TIS2024-FMFI/telescope-safety/(threads)

Thread 4 (2024-10-07):

Research of available technologies

Mi-Zel, 2024-10-07:
Find usable technologies for implementation.

pavelpetrovic, 2024-10-07:
túto knižnicu sme testovali:
  https://github.com/ElectronicCats/mpu6050

Mi-Zel, 2024-10-07:
https://rpishop.cz/orientace-v-prostoru/2100-waveshare-10-dof-imu-sensor-d-gyroskop-akcelerometr-kompasmagnetometr.html

https://rpishop.cz/senzory/1404-waveshare-10-dof-imu-sensor-c-gyroskop-akcelerometr-kompasmagnetometr.html

Myšlienka na preskúmanie: Nešlo by pomocou kompasu kompenzovať odchylky v meraní akcelerometra? Pripadne ich vyhodnocovať a v správnom čase hodnoty resetovať?

Mi-Zel, 2024-10-07:
Senzory sú závislé na teplote okolia.
Konkrétny príklad jedného senzora je:
Operatívny od -40 do 85 °C
Plná presnosť od 0 do 65 °C

Nakoľko sa nachádzame v otvorenom priestore, potenciálne tu môžu byť vysoké výkyvy teplôt (hlavne negatívne), ktoré by mohli ovplyvniť meranie.

Pri výbere technológií treba pamätať j na fakt, že sa nachádzame v otvorenom priestore, pripadne vyriešiť ohrev komponentov. Na teploty >0. Je možné,  že systém sa bude ohrievať sám spotrebou elektriky. Treba však na túto potenciálnu hrozbu pamätať.

pavelpetrovic, 2024-10-08:
ano, väčšina senzorov má zabudovaný aj teplomer, ak to bude v uzavretej krabičke, tak už aj to pomôže, lebo si to bude trochu kúriť, ale pridať tam ešte nejaký rezistor, napr. https://techfun.sk/produkt/rezistor-vykonovy-rozne-typy/ povedzme pripojený cez nejaký spínací tranzistor na jednom PWM pine by mohlo príliš nízku teplotu upraviť.

Mi-Zel, 2024-10-14:
Cele by sa to dalo nasetupovat pomocov RPi (alebo inych obdobnych zariadeni).
RPi5 (alebo nizsia rada) by bolo pripojene k Ethernetu a malo tak pripojenie na siet. Zaroven by si vytvaralo vlastnu bezdrotovu siet, do ktorej by sa pripojil modul, ktory by bol na dalekohlade (RPi Pico W alebo RPi Zero W). Komunikacia by sice bezala na rovnakej frekvencii ako wifi (2.4), ale tato frekvencia stale spada pod radiove vlny, ako je v poziadavkach a ma implementovanu spolahlivu komunikaciu s Collision Avoidance. RPi5 by nasledne sluzilo ako jednoduchy webserver pre zobrazenie informacii a konfiguraciu systemu.

Dalsie mozne riesenie komunikacie je pouzit radio modul [NRF24L01](https://techfun.sk/produkt/nrf24l01-2-4ghz-modul-pre-prenos-udajov/), ktory podporuje full-duplex komunikaciu. Tento modul by sa dal v pripade nedostatocneho vykonu vymenit za vykonnejsi modul, ktory obsahuje zosilovac signalu [NRF24L01 PA/LNA](https://techfun.sk/produkt/nrf24l01-palna-2-4ghz-modul-s-antenou/).
Oba pouzivaju identicku kniznucu a identicky medzikus ([adapter](https://techfun.sk/produkt/adapter-pre-bezdrotovy-modul-nrf24l01/)) pre odladenie napati. Modul ma istu formu ACK. Podla nej si vieme znovu posielanie packetov konfigurovat sami, alebo pouzit moduly z kniznice (modul by sa mal pokusit opakovane zasalt packet 15x). Modul je mozne nastavit na 125 roznych kanalov a v kazdom kanale otvorit pipes na komunikaciu s vlastnymi adresami. Kazdy modul vie mat otvorenych 6 pipe (1 na ACK, takze 5 uzivatelskych). Takto moze byt jedna nastavena na odosielanie a druha na prijimanie dat pre full-duplex komunikaciu.

pavelpetrovic, 2024-10-15:
Tie moduly, čo píšete, myslím komunikujú na 2.4 GHz, a preto by sa pravdepodobne rušili s Wifi. Dr. Žigo hovoril o frekvencii 868 MHz. Na tom fungujú tie moduly typu LoRa, dal som aj linku na také, čo aj budeme čoskoro mať na otestovanie do katalógu požiadaviek. Zatiaľ verím, že by mali fungovať tak, že naraz môže komunikovať aj viac ako dve zariadenia, takže by sa jednoducho dala dupliklovať riadiaca jednotka, aby mohla byť aj v miestnosti, kde je teleskop - lebo tam podľa mňa treba niečo mať, nikto nebude loziť hore na teleskop, aby to konfiguroval a určite ale chcú mať aj niečo tam, kde je výskumník, takže mi to vychádza, že treba mať dve - ak budú na tej istej "rádiovej sieti", tak môžu byť jednoducho duplikované a navzájom si mirrorovať informácie, ak používateľ nejaké zadá priamo cez jednu z nich. Informácie, ktoré by vysielala inerciálna jednotka by mali zachytiť obe.
Celkovo hardvér, ktorý je aktuálne vylistovaný v odkazoch, budete mať veľmi čoskoro dostupný na testovanie. K riadiacej jednotke - aby sme zbytočne nepremršťovali cenu by sme asi mohli použiť Raspberry Pi Pico, ktoré komunikuje aj po ethernete - alebo ak by to nebolo dostatočne dobré, tak potom asi Raspberry 4, ale myslím, že bohate bude stačiť 2GB pamäte, lebo pamäť ich dosť premršťuje. To relé by asi malo byť vyvedené ešte von do nejakej inej škatulky, kde bude aj (prerušiteľná) zásuvka na 230V, aby do škatulky s riadiacou jednotkou nešlo priamo 230V.

Mi-Zel, 2024-10-15:
Rozprávali sme sa s nimi o 2 prijímacích zariadeniach, na čo nám bolo povedané,  že chcú iba jedno v riadiacej miestnosti,  do ktorej budú zaradené 2 drôty z riadenia pohybu na potrebné odpojenie (chcú od nas, len aby na tej jednotke bolo relé)
Majú to teda byť čisto 2 zariadenia: jedno s gyroskopom a druhe s displayom, relé spínačom, ktoré bude navyše zabezpečovať komunikáciu s užívateľskými zariadeniami.

pavelpetrovic, 2024-10-15:
Ja viem, ved som tam bol, ale myslim si, ze to nemusi byt finalna predstava, diskutovalo sa aj o tejto moznosti pocas diskusie a mne sa zda, ze tie dovody, ktore som napisal, skor hovoria za to riesenie s dvoma. Je to ale vyspecifikovane tak, ze to skoro vobec neovplyvnuje, ci budu dve alebo jedna, len treba dat pozor, aby sa to navzajom nebilo a este aby sa odzrkadlilo na druhu jednotku co pouzivatel vyberie, to nie je tak narocne. Ale tak ako to je vyspecifikovane by to vyhovovalo aj rezimu prace iba s jednou jednotkou a taketo riesenie je elegantne v tom, ze umozni aj dve, ak sa to niekedy bude zdat uzitocne a zaroven umozni prevadzku aj s jednym.

pavelpetrovic, 2024-11-04:
Zo stretnutia:

- prosim poriadnejsie zapisnice - treba uz pracovat aj na testovacich scenaroch
- neviem, ci som Vam uz ukazoval, ze mame aj alarm sirenu - ktora blika aj sialene vresti, je na 12V, ale mame k nej prevodnik z 5 na 12V, este nam chyba ta powerbanka
- navrhnite svoj komunikacny protokol medzi jednotkami a zdokumentujte ho v navrhu
- treba nakreslit navrh pouzivatelskeho rozhrania
- nasli sme softverovu SPI kniznicu https://github.com/red-scorp/SoftSPIB
- treba zistit ako sa daju prepinat piny na RPI PICO pre HW SPI - lebo su tam osadene viacnasobne alternativy, zrejme nejakym registrom sa to prepina/vybera?
- zatial skusime ist tou cestou, ze vsetky zariadenia budu RPI PICO - bud s ETH modulom pre riadiacu jednotku alebo PICO2 pre inercialnu jednotku, cize k riadiacej by mal byt pripojeny: ETH kabel, radio modem, tlacidla, display s SD kartou, alebo display a SD karta, k inercialnej jednotke iba senzor a radio.  ak s tym budu problemy, tak sa prepneme na ten RPI ZERO s externym modulom pre ETH.
- ten dalsi senzor, co je na ceste je tento https://www.aliexpress.com/item/1005005494956365.html (pridal som ho do zoznamu v KP)
- ja vyskusam modem a displej, Vy vyskusajte web server
- ak chcete stvrtok poobede sa da prist testovat senzory...

Closed 2024-12-16.

Thread 10 (2024-10-14):

Plán implementácie

Mi-Zel, 2024-10-14:
v akom poradí sa budú implementovať, testovať a navzájom spájať jednotlivé komponenty

JanRZ003, 2024-12-08:
Modul s inerciálnou jednotkou
program v jazyku C vytvorený vo vývojovom prostredí Arduino IDE na Teensy doske pre získanie údajov z inerciálnej jednotky 10 DOF IMU Sensor,ICM20948 vo forme Eulerových uhlov, výpočet kvaterniónov
program na Teensy doske pre vysielač Arduino Lora v jazyku C vytvorený vo vývojovom prostredí Arduino IDE na rádiové zasielanie údajov získaných vo vyššie opísanom programe Ján Radovan Zubo 🐤

Riadiaca jednotka
program v jazyku C vytvorený vo vývojom prostredí virtual studio code pre spracovanie údajov prijatých u prijímača arduino lora
program v jazyku C na vyhodnotenie nebezpečenstva podľa získaných a konfiguračných údajov, spúšťanie alarmu, vypnutie systému Ján Radovan Zubo 🐤

program v jazyku C pre príjem HTTP requestov a distribúciu statických súborov
program v jazyku C pre príjem HTTP POST requestov na konfiguráciu systému
program v jazyku C pre príjem HTTP POST requestov na zipovanie a stiahnutie logovych dat
program v jazyku C pre upgrade HTTP na WebSocket a naslednu distribuciu aktuálnych dát z inerciálnej jednotky Mikuláš Zelenák 🦊

program pre logovanie dát, posielanie na webový server
program na vypísanie dát na displej Ivana Zeleňaková 🐹

program v html, css a javascript jazyku pre stránky používateľského rozhrania(konfiguračná stránka, informačná stránka) Mariia Lementa 🦝

pavelpetrovic, 2024-12-09:
ak by ste nemali nic proti, tak by som hlasoval skor za RPI PICO ako Teensy, predsa len je to 7 Eur vs. 44 Eur. Aj keby ste nutne chceli mat SD-kartu pri gyroskope, tak modul pre SD kartu je 1.20...  Myslim si, ze z hladiska programovania ani nepocitite rozdiel.

Pri testovani som pouzil teensy, lebo ten som mal v prostredi Arduino uz rozbehany a bol po ruke, ale inak by to malo byt jedno.

Tiez by bolo super, ak by sme vedeli otestovat aspon dva rozne senzory v realnych podmienkach (snad najskor na tom modele, co ste zostrojili), aby sme ich vedeli porovnat.

Potom tiez netreba riesit nejaky HTTP alebo nebodaj Websocket az na inercialnej jednotke, lebo budu prepojene s riadiacou tym radiovym modemom, takze tam funguje posielanie oboma smermi podla protokolu, ako si spravite, nemusite riesit HTTP.

Nezabudnite na to, ze pred implementaciou  je potrebne tieto veci este aj navrhnut a zapisat do navrhu.

Thread 19 (2024-10-24):

HW testing

Mi-Zel, 2024-10-24:
Test all the sensors and other HW

Mi-Zel, 2024-10-24:
https://www.raspberrypi.com/documentation/microcontrollers/c_sdk.html#sdk-setup

Mi-Zel, 2024-11-04:
Sposoby ako zdieľať data medzi jadrami:
https://forums.raspberrypi.com/viewtopic.php?t=340588

pavelpetrovic, 2024-11-25:
prvy test - dve radia komunikuju z arduina ok
https://www.youtube.com/shorts/FG-sJ_2mkPE
pouzil som tuto kniznicu https://github.com/sandeepmistry/arduino-LoRa
zatial jedno je vysielac, druhe primac, neskor este otestujem obojsmerne

pavelpetrovic, 2024-11-27:
len hlasim, ze komunikacia medzi radiami funguje pekne aj obojsmerne
(z kniznice priklad LoRaDuplex.ino)

pavelpetrovic, 2024-11-30:
Displej aj SD-karta, ktora je v nom funguju...
https://www.youtube.com/watch?v=oertZe1MlqU
(subor tam ostal - ako hovorim na videu - iba ked sa zmazanie zakomentovalo, inak bol zmazany)

pavelpetrovic, 2024-11-30:
pokracujem testom senzora SparkFun 9DoF - ICM-20948, v predchadzajucom sa quaterniony pocitali tou softverovou kniznicou, tu sa pocitaju v DMP priamo v hardverovom cipe. Akurat je tym padom kod taky velky, ze to nevojde do 32KB flash obycajneho Arduina, takze som pouzil Teensy 4.1, ale bez problemov to slo. V zdrojakoch kniznice treba odkomentovat, aby sa DMP pouzivalo (je to navrchu zdrojaka prikladu vysvetlene). Pouzita je standardna kniznica od Sparkfun k tomuto senzoru. Ma trochu problem, ze po inicializacii trva chvilu, kym sa ustalia hodnoty, najma roll, potom uz zda sa funguje. Testoval som iba rezim 6DOF, kedze kompas asi nebude pouzitelny. Takze toto tiez kandiduje na pouzitie a bolo by ich dobre porovnat dokladnejsie.
https://www.youtube.com/watch?v=VX2zd2Eqg7Y
knzinica je ICM_20948.h, priklad 7.

pavelpetrovic, 2024-11-30:
skusil som aj ten modry - jeden taky podobny, len trochu iny mate...
tento obsahuje MPU9250 a kompas, ale hoci sa mi zdalo, ze to mozno pouziva aj kompas,
tak to bude myslim iba tych 6DOF (co je dobre).
pouzil som kniznicu fastIMU, https://github.com/LiquidCGS/FastIMU
ktora podporuje cely rad roznych IMU a aj tento...
quaterniony, ak som dobre pochopil sa tiez rataju vnutri v DMP.
pridal som do programu prepocet na YPR - len zobral z ineho programu vyssie, kde ten vypocet bol tiez.
tomuto trva tusim este dlhsie, kym sa na zaciatku najde a potrebuje pomerne dost narocnu kalibraciu - ktora sa ale da preskocit
a pouzit predtym vytvorena.
https://youtube.com/shorts/x0EQ1ctWCxU

pavelpetrovic, 2024-11-30:
Tak aj ten posledný gyro funguje celkom pekne. Dá sa mu nastaviť jeden z viacerých možných módov, tak som vybral taký bez kompasu. Má aj samostatný program na kalibráciu. Použil som knižnicu https://github.com/arduino-libraries/BNO055
ak som dobre pochopil tak od výrobcu.
Tento zdá sa nemá problém s hľadaním hodnoty na začiatku, vyzerá byť trochu závislý od kalibrácie. A keď nepoužíva kompas, tak sa snáď ani nebude automaticky resetovať ako písali na nejakých fórach.
https://youtube.com/shorts/yloB6HkRB1A

pavelpetrovic, 2024-11-30:
podarilo sa Vám rozbehať ten webový server, alebo skúsim aj to?

Mi-Zel, 2024-11-30:
Áno. Webový server je pushnuty funkcny v branch-i na testovanie

pavelpetrovic, 2024-12-09:
doplnam spravne nastavenie pinov pre radia:

const int csPin = 10;          // LoRa radio chip select
const int resetPin = 9;       // LoRa radio reset
const int irqPin = 2;         // change for your board; must be a hardware interrupt pin

pavelpetrovic, 2024-12-13:
dobré správy:

rádio a SD karta z W55RP20-EVB-PICO fungujú súčasne, pričom ostávajú ešte voľné piny:
0,1,9,14,15,26,27,28 - z toho 0,1 je bežná sériová linka, tadiaľ by to mohlo komunikovať s Arduinom, aby
mu posielalo príkazy, čo vykresliť na displeji, prípadne kam používateľ klikol, ak chceme využiť aj dotykový
displej a stále ostáva 6 pinov. dúfam, že keď sú rádio aj SD karta pripojené, tak bude fungovať aj ethernet...
toto by bolo ešte treba vyskúšať. Teraz mám pocit, že bude asi najlepšie dať tam toto arduino nano a nebude
treba odrezávať nožičky pre SD kartu z displeja zvlášť.
prikladám program, ktorý komunikuje cez rádio aj obsluhuje SD-kartu, ktorý mi ide:
[picoeth_sd_and_radio.zip](https://github.com/user-attachments/files/18125726/picoeth_sd_and_radio.zip)

ešte som konečne skúšal aj aký dosah má rádio. nie je to až také valné, ale v tejto budove je veľa železobetónu:
keď bolo rádio v labe, tak som ešte zastihol signál v polovici chodby smerom k oáze so šachovnicou a v tej
prepojovacej chodbe pozdĺž celej H6, ale pri H3 už nie. Takže keď nabudúce niekto pôjde na hvezdáreň,
treba to tam ísť vyskúšať. Ale ešte tam bol aj pin ANA, ktorý je asi iba zle označený pin ANT. ChatGPT poradil
vzorec, ktorým sa dá vypočítať správna dĺžka antény, tak som tam napájkoval 8.6 cm pevný drôt na oba
a rozsah sa zvýšil tak, že sa dá vyjsť von z informatiky a až v tej chodbe na vrátnicu to začne viac blbnúť.
Celkovo ale bude treba kontrolovať prijaté pakety a opakovať, keď sa neprijmú správne, občas to nejaké
písmenko zmení - najmä keď už je to ku koncu vzdialenosti. Asi sa tam ešte softvérovo dá upraviť nejaký
register, aký má gain, ale to až zasa nabudúce. Ale už aj takto je to teda zrejme dosť, takže to ani netreba
ísť skúšať.

pavelpetrovic, 2024-12-16:
prepojil som SD-kartu s dalsim PICO aby sa to dalo rozdelit.
takze tu su dva programy - pre adruino a pre pico2, pricom
pico2 chodi na SD kartu a Arduino na displej.

navzajom komunikuju cez SoftwareSerial - funguje to.
[displej_a_sd.zip](https://github.com/user-attachments/files/18148543/displej_a_sd.zip)

pavelpetrovic, 2024-12-18:
Prekonzultoval som pre istotu s nasim spravcom, co vravi na to riesenie s mDNS.
Vravel, ze je to sice malo vyuzivana, ale ze jeden system na katedre tak funguje a vzdy to zafunguje a ze by s tym nemali byt problemy, takze stahujem moje frflanie na mDNS - urobte ako chcete - ci uz cez ten skript na nejakom servri na fakulte, alebo cez mDNS ako local adresa.

pavelpetrovic, 2025-01-20:
Po troch hodinach zabavy sme nasli sposob, ako urobit webserver na tej veselej doske W55RP20-EVB-PICO.
V tomto projekte to sice este nie je webserver, iba TCP server, ale to uz je snad malina.

pouzili sme default example Wifi-WifiServer a lwIP_w55rp20-WifiClient-W55RP20.

[w55rp20-evb-pico-eth-tcp-server.zip](https://github.com/user-attachments/files/18481206/w55rp20-evb-pico-eth-tcp-server.zip)

Mi-Zel, 2025-02-06:
Pri snahe zapisat schemu som objavil ze sa antena na radii toci. Je pevne v lepidle (nevytahuje sa) ale toci sa v nom.
Obavam sa ze tam nie je najlepsi kontakt a pred instalaciou to bude treba prepajkovat.

pavelpetrovic, 2025-02-08:
zohnal som nejake dve powerbanky, pripravil napajanie a predbezne som vypotil krabicku pre inercialnu jednotku, skusim vytlacit, na prvy raz to takmer isto nesadne, ale treba vyskusat. skusim aj pre riadiacu, to bude vacsia fuska, zislo by sa, keby ste to potom doniesli, napr. v pondelok, aby sme dotiahli kabelovanie...
https://www.tinkercad.com/things/2qtOncCJI9N-inercial-unit

Thread 23 (2024-12-02):

Issue cviciaci

pavelpetrovic, 2024-12-02:

pavelpetrovic, 2024-12-02:
2/12
Mikulas je chory ostatni pritomni
v zapisnici musi byt napisane, kto ma co na starosti do buduceho tyzdna
vysoka priorita je dokladne v time prediskutovat:
1) navrh pouzivatelskeho rozhrania, aby ho niekto mohol nakreslit
2) rozdelenie na moduly a ich rozhrania, tiez niekto zdoumentuje formou UML component diagram
3) plan implementacie - s podrobnymi jednotlivymi ulohami, ktore sa idealne daju nezavisle vykonat (a teda z nich asi budu issues, alebo budu zdruzovane do vacsich issues)
potom spojit vsetko do hotoveho navrhu.

pavelpetrovic, 2024-12-09:
9/12
vsetci pritomni
zapisnica OK
tim vypracoval navrh rozdelenia na casti a komponentny diagram: ok
tim vytvoril plan implementacie: moze byt
tim vytvoril navrh pouzivatelskeho rozhrania - v navrhu prosim timy, aby vypracovali kompletny navrh aj tie casti, ktore su "optional", aby bol urobeny tak, aby sa tie casti potom dali pridat, ked sa pridavat budu
inak celkovo dobra praca.

je potrebne vytvorit implementacne issues a este raz sa v time podrobne porozpravat ako sa budu implementovat jednotlive casti - idealne vytvorit prazdne hlavicky metod a tried pre cely projekt,

potom ich uz mozu jednotlivi vyvojari podoplnat.

Myslim si, ze az tak nie je potrebne teraz robit dalsie testovanie hardveru, kym nemate softver, ten pojde vychodiskovo skompilovat aj na RPI PICO aj na Teensy - oboje ak sa bude programovat z prostredia arduino

mame jednak PICO W a jednak PICO 2 a jednak to PICO s ethernetom (W55RP20-EVB-PICO); beznym rozsirenim pre HW dosky od Arduina idu iba niektore, ale vsetky by mali ist tymto rozsirenim:
https://github.com/earlephilhower/arduino-pico
vyskusal som vsetky tri naprogramovat jednoduchy program a naspat vypisovat cez USB na seriovy port a vsetky tri isli - aj ten napajkovany, co ste mali, aj tie zvysne dva

vyskusam prepojit displej s tym W55RP20 a uvidime, kolko ostane pinov volnych, ci aj I2C este ostane volna a druhe SPI - a tiez, ci to dokaze teensy - toto si beriem na zodpovednost vyskusat.

cize asi netreba, aby ste sem chodili vsetci spolu testovat hw, az ked niekto bude mat nejaky SW komponent, ktory nejaky HW potrebuje, tak sa dohodne individualne a pride otestovat.

zamerajte sa, prosim, na to spolocne premyslenie implementacie az na uroven metod a potom kazdy na naimplementovanie vlastnej casti.

pavelpetrovic, 2025-01-04:
Asi viete, ale pre istotu: potom ak by ste nahodou robili v Arduino IDE vacsi projekt, tak tam moze byt aj viac suborov - tie maju potom priponu .cpp, pripadne .h a iba jeden sa vola .ino, podla neho sa vola aj adresar v ktorom je. Vsetky tieto sa zobrazia potom po otvoreni toho .ino ako jednotlive zalozky v IDE. Takto mozno udrzat jednotlive subory tematicky zamerane a v rozumnej dlzke. Vela zdaru.

pavelpetrovic, 2025-01-20:
pekny clanok o doske s eth:  https://community.element14.com/technologies/internet-of-things/b/blog/posts/review-wiznet-w55rp20-evb-pico

pavelpetrovic, 2025-02-15:
pozrel som si dokument, mam este tieto drobne postrehy:

- predovsetkym potrebujem, aby v dokumente bol komunikacny protokol medzi jednotkami
  (konkretne pakety do posledneho bitu, ktore si vymienaju, aj aspon nejaka veta-dve k tomu)
- popis protokolu medzi W55RP20-EVB-PICO a arduino
- popis websocket protokolu, ake tam chodia pakety
- to API, ktore tam mate vysypane... hmm.
  je to trochu neprehladne. dalo by sa bud pouzit nejaky doxygen a spravit z toho poriadnu api dokumentaciu, ale to asi pre tento projekt netreba,  ale aspon keby tam bol syntax highlighting. myslim, ze ak by to bolo v inom IDE ako arduino, tak copy&paste do wordu by mohol zachovat zvyraznenie syntax highlighting, mozete pripadne vyskusat...
- mozete trochu pozriet aj preklepy, napr:
- V moduli s inerciálnou jednotkou => https://www.eduself.sk/slovensky-jazyk/tvary-slova/modul
- bezdrátovú => po slovensky drôt, nie drát :)
-  azimutu a elevácia => e
- MAC adreru
- Všetku logové súbory
- poligóny => y
- pred "a uložiť ich do Dokumenty/Arduino/libraries" by som pridal
   "bud priamo pomocou Arduino IDE Library managera alebo ich uložiť..."
- hardver, k inercialnej jednotke mozete pridat:
    - zdroj 5V4A (https://chipskey.en.made-in-china.com/product/ATJRiUelIGWN/China-47126-Output-5V-97-Mini-DC-DC-15V-12V-9V-7-4V-to-5V-4A-Step-Down-Buck-Power-Converter-Charging-Volta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)
    - powerbanka (https://www.alza.sk/spello-vreckova-powerbanka-5000-mah-cierna-d12422928.htm)
    - link na radio je: https://techfun.sk/produkt/komunikacny-modul-sx1276-lora-433-868-915-mhz/
- mate tam 2x schemu riadiacej jednotky, inercialna je tu:
   https://github.com/TIS2024-FMFI/telescope-safety/blob/main/docs/schemes/inertial_unit.png

- hardver k riadiacej jednotke:
   link na displej: https://techfun.sk/produkt/tft-display-shield-3-5-pre-arduino-uno-s-sd-kartou
   link na mosfet: https://techfun.sk/produkt/dual-mosfet-pwm-regulator-aod4184a/
   link na rele: https://techfun.sk/produkt/rele-modul-1-kanal-5v/
   link na sirenu: https://techfun.sk/produkt/sirena-12v-ls-103/

- v dokumente by mali byt aj testovacie scenare
- mozete pridat aj link na krabicku pre inercialnu jednotku, prip. aj jej obrazok ako sa zobrazuje na tinkercade
   https://www.tinkercad.com/things/2qtOncCJI9N-inertial-unit

Thread 24 (2024-12-15):

Sensor data gaining

JanRZ003, 2024-12-15:
Implementation issue for module with inercial unit

JanRZ003, 2024-12-15:
-v branchi pre modul s inerciálnou jednotkou som pushol kod na nacitavanie dat(Eulerovych uhlov) do serial monitoru v arduino IDE
-rozbehol som to cez raspberry pi pico 2 so senzorom waveshare 10 DOF IMU sensor (D) ICM_20948
-dalsia aspiracia je transformacia na elevaciu a azimut

JanRZ003, 2025-01-01:
získavanie roll, pitch, yaw pomocou senzoru waveshare 10 DOF IMU sensor (D) funguje a je to už aj sem pushnute do repozitára v dohodnutej forme návrhu implementácie, ešte v rámci tejto issue spravím získavanie týchto údajov pomocou iných senzorov s využitím iných knižníc, ale to až neskôr, nakoľko chcem spraviť progres aj v iných issues

Closed 2025-01-21.

Thread 25 (2024-12-15):

Transmitting data via radio

JanRZ003, 2024-12-15:
Implementation issue where updates on transmitting data(from module with inercial unit to control unit via radio)will be documented through comments

JanRZ003, 2025-01-13:
-pushol som do repozitara do paralelnej branche funkcny kod ktory posiela cez lora modul azimut a elevaciu kazdu pol sekundu ktore sa prave namerali
-skusal som to normalne na raspberry pi pico 2, kedze napajanie a zem(3v3 a gnd) na mikropocitaci vyuziva senzor(inercialna jednotka) tak som radio napajal cez mikropocitac s ethernetom(toto este treba poriesit cez breadboard napriklad)
-azimut a elevaciu som posielal mikropocitacu arduino nano ktory ma stale level shiftery
-aj spätna komunikacia funguje a raspberry pi pico 2 vie prijimat spravy od arduino nano
-najskor som to skusal r mikropocitacom s ethernetom ako som to dostal ale nevedela sa lora setupnut a neviem preco, dost dlho som to riesil aj s pomocou a nefungovalo
-takze ciel je zbavit sa level shifterov a arduino nano nahradit mikropocitacom s ethernetom lebo tak to chceme v nasom systeme
-tento isssue by som po vasich pripomienkach a code review navrhoval oznacit ako done

Closed 2025-01-17.

Thread 43 (2025-01-01):

Prevod roll, pitch, yaw na azimut a eleváciu

JanRZ003, 2025-01-01:
Implementačná issue kde bude zaznamenaný progres v kódení prevodu údajov roll, pitch, yaw na azimut a eleváciu

JanRZ003, 2025-01-07:
Spravil som prevod na azimut a elevaciu z roll, pitch, yaw a pushol som to do repozitára zatiaľ do paralelného branchu. Keďže gain roll, pitch, yaw sa vykonával vzhľadom na globálny súradnicový systém zeme a nie vzhľadom na lokálne osi senzora, v podstate stačí stotožniť yaw s azimutom a pitch s eleváciou. Ibaže pri výpočtoch roll, pitch, yaw nadobúda uhol yaw hodnoty(-180 až 180) a pitch hodnoty -90 smerom nahor a 90 smerom nadol(naopak ako elevácia). Preto som v kóde použil štandardný postup pre prevod týchto uhlov cez rotačné matice a referenčný vektor. Referenčný vektor sa však nemení práve kvôli globálnemu charakteru výpočtu roll, pitch, yaw(ak by to bolo lokálne museli by sme si referenčný vektor kumulatívne zapamätávať pre každé ďalšie zavolanie funkcie). Takže azimut a elevácia sú v správnom tvare. Takýmto spôsobom je tiež tento kód prevodu modulárne pripravený na gain roll, pitch, yaw od iných inerciálnych senzorov. Issue #43 ešte navrhujem nezatvárať lebo správne meniace sa hodnoty azimutu a elevácie pri pohybe uvidíme až pri teste na školskom modeli teleskopu čo sme vytvorili.

Closed 2025-01-21.

Thread 52 (2025-01-17):

Testing on Lego model

Mi-Zel, 2025-01-17:
- [ ] Test if azimuth, elevation conversion is working correctly
- [ ] Test sending azimuth elevation via web server
- [ ] Test correctly writing logs
- [ ] Test display
- [ ] Test calibration

Closed 2025-02-10.

Thread 53 (2025-01-20):

sensor reset

JanRZ003, 2025-01-20:

JanRZ003, 2025-01-20:
-resetovanie senzoru som nakoniec riesil cez pin mikrokontrolera cez prikaz digitalWrite a nie cez mosfet
-azimut prijaty z riadiacej jednotky(vramci reset prikazu) sa pekne nakalibruje a aj ked sa azimut nema zmenit ale len senzor resetnut tak azimut vie zachovat svoju hodnotu pred resetom
-kod je pushnuty v paralelnej branchi, vytvorim pull request
-potrebuje to samozrejme testovat nakoľko nas projekt vyzaduje velku presnost(testy ktore som robil ja sa zdali funkcne)

Closed 2025-01-21.

Thread 120 (2025-02-08):

Dotiahnut posledne detaily

Mi-Zel, 2025-02-08:

Mi-Zel, 2025-02-08:
Pri testovani vypnutia jednotky po 5 minutach sa mi zatial nepodarilo zduplikovat chybu. Loop a vypisy bezia bez problemov vyse 20 minut.
Jednotka bola testovana cisto ako riadiaca jednotka, bez prijimania dat z inercialnej, nakolko HW k inercialnej jednotke nedisponujem.

Mi-Zel, 2025-02-08:
System bezi aj 30 minut bez problemov.
Pocas tohoto casu mal pripojenych 3 klientov, ktory neustale robili HTTP requesty. Tiez sa odpajali a pripajali na WS a bezi to cele bez problemov.

Odhadujem teda, ze problem bude niekde v casti s citanim z radia, vyhodnocavani prijatcyh data, pripadne odosielanim tychto dat klientom a zapis tychto dat do log suborov. (posledne 2 moznosti mi pridu velmi nepravdepodobne, nakolko bolo pri chybe logoavnie vypnute a chyba nastavala aj ked neboli pripojeny na WS ziadni klienti a teda sa klientom nic neodosielalo)

@JanRZ003 Vedel by si sa pozriet na to radio co si robil, ci sa cely system nemoze nahodou niekde zacyklit ked nespravne prijime packet alebo nejaka ina chyba?

Mi-Zel, 2025-02-08:
Po hodine sa Prestalo vypisovat na Serial monitor, ale web server bezal bez problemov dalej (3h) az do manualneho vypnutia

pavelpetrovic, 2025-02-08:
to je smutne, ze to zasa prestalo.

* pri komunikacii - asi by bolo dobre, aby to raz za cas poslalo paket aj ked nedojde k zmene pozicie, inak sa komunikacna linka moze pokazit

* druha vec - skusil by som este vypnut cele Arduino IDE a otvorit komunikaciu cez Putty na tom seriovom porte, ci aj tam sa to zastavi. v programe sa da testovat, ci seriova linka je este ziva

* este jedna moznost by bola pouzit watchdog timer - to je taky timer, ktory ked vyprsi do nuly, tak resetne celu dosku.
takze kym to bezi, tak mu treba stale hovorit, aby zacal pocitat od zaciatku, aby k resetu dosky nedoslo, ale ked sa hlavna slucka niekde zasekne, tak watchdog timer dobehne do nuly a resetne dosku...
po resete sa da zistit, ci nastal kvoli watchdog timeru...
ale neskusal som to s rpi pico...  nejaka inspiracia je tu: https://github.com/raspberrypi/pico-sdk/blob/master/src/rp2_common/hardware_watchdog/include/hardware/watchdog.h

pouzivate tam niekde nejaku dynamicku pamat?
vyhol by som sa akymkolvek objektom a strukturam c++...

pavelpetrovic, 2025-02-08:
pripadne by ten reset mohlo este jednoduchsie zabezpecit to arduino s displejom:
 - staci prepojit nejaky volny pin na arduino s pinom RUN, nastavit ho ako vstupny.
 - arduino bude dostavat pravidelny "ping" z rpi pico a ak nedostane, tak ten pin na chvilocku uzemni a to tu dosku resetne.

JanRZ003, 2025-02-09:
potom co riadiaca jednotka vypadla sme skusili reset senzoru stlacenim tlacidla a reset command sa poslal aj vykonal, cize radio vypadnute nebolo. hned potom co sa vykonal reset znova riadiaca zacala bezat v serial monitore.

Mi-Zel, 2025-02-09:
Ano, po 20 minutach radio prestalo prijimat, ale program dalej bez problemov bezal na riadiacej jednotke. Inercialna dalej odosielala. Ked sme cez riadiacu poslali restart senzora na inercialnej, po restarte sa vysielane udaje zacali opat prijimat.
Vyzera to tak, ze bude nejaky rpoblem s radiom. Este pokracujeme v testovani

Closed 2025-02-09.
