TIS2024-FMFI/telescope-safety/src/control_unit/control_unit_A/config_parse.cpp

#include "config_parse.h"
#include <stdlib.h>

ForbiddenZones systemForbiddenZones;

int setUpZones(const char* newConfiguration) {
  std::string_view config(newConfiguration);
  std::string_view::size_type current = 0;
  std::string_view::size_type end = 0;

  ForbiddenZones temp_zones;
  ForbiddenZone temp_zone;
  int pointCount = 0;
  bool inZone = false;

  while (current < config.size()) {
    // Find the end of the line
    end = config.find('\n', current);
    if (end == std::string_view::npos) {
      end = config.size();
    }

    // Extract the line as `std::string_view`
    std::string_view line = config.substr(current, end - current);
    current = end + 1; // Move to the next line


    // Trim whitespace from the start and end
    while (!line.empty() && (line.front() == ' ' || line.front() == '\t')) {
      line.remove_prefix(1);
    }
    while (!line.empty() && (line.back() == ' ' || line.back() == '\t')) {
      line.remove_suffix(1);
    }

    // Ignore comments and empty lines
    if (line.empty() || line[0] == '#') {
      if (line.empty() && inZone) {
        // Finish the current zone
        if (pointCount < 3) {
          return -1; // Error: Zone contains fewer than 3 points
        }

        // Sort the current zone clockwise before storing it
        // Ray-casting algorithm in danger evaluation requires this sort
        sortZoneClockwise(temp_zone);

        temp_zones.push_back(std::move(temp_zone));
        temp_zone.clear();
        pointCount = 0;
        inZone = false;
      }
      continue;
    }

    // Parse a point (azimuth, elevation)
    double az, el;
    if (sscanf(line.data(), "%lf %lf", &az, &el) != 2) {
      return -2; // Error: Invalid line format
    }

    // Add the point to the current zone
    temp_zone.push_back({az, el});
    pointCount++;
    inZone = true;
  }

  // Finalize the last zone
  if (inZone) {
    if (pointCount < 3) {
      return -1; // Error: Zone contains fewer than 3 points
    }

    // Sort the current zone clockwise before storing it
    //Ray-casting algorithm in danger evaluation requires this sort
    sortZoneClockwise(temp_zone);

    temp_zones.push_back(std::move(temp_zone));
  }

  // Update the global forbidden zones
  settings.systemForbiddenZones = std::move(temp_zones);
  return 0; // Success
}

// Function to compute the centroid and sort points in clockwise order
void sortZoneClockwise(ForbiddenZone& zone) {
  if (zone.size() < 3) return; // No sorting needed for less than 3 points

  // Step 1: Calculate the centroid
  AzimuthElevation centroid = {0.0, 0.0};
  for (const auto& point : zone) {
    centroid.azimuth += point.azimuth;
    centroid.elevation += point.elevation;
  }
  centroid.azimuth /= zone.size();
  centroid.elevation /= zone.size();

  // Step 2: Sort points in clockwise order based on the centroid
  std::sort(zone.begin(), zone.end(),
            [&centroid](const AzimuthElevation& a, const AzimuthElevation& b) {
                return calculateAngle(a, centroid) < calculateAngle(b, centroid);
            });
}

// Helper function to calculate the polar angle relative to the centroid
double calculateAngle(const AzimuthElevation& point, const AzimuthElevation& centroid) {
  return atan2(point.elevation - centroid.elevation, point.azimuth - centroid.azimuth);
}

int setUpMatrix(const char* newMatrix){
  std::string_view config(newMatrix);
  std::string_view::size_type current = 0;
  std::string_view::size_type end = 0;

  int rowIndex = 0;  // To keep track of which row we're filling
  // Split by lines
  while ((end = config.find('\n', current)) != std::string_view::npos && rowIndex < 3) {
    std::string_view line = config.substr(current, end - current);
    current = end + 1; // Move past the newline

    int value0;
    int value1;
    int value2;
    int value3;

    if (sscanf(line.data(), "%d;%d;%d;%d", &value0, &value1, &value2, &value3) == 4){
      TransformMatrix[rowIndex][0] = value0;
      TransformMatrix[rowIndex][1] = value1;
      TransformMatrix[rowIndex][2] = value2;
      TransformMatrix[rowIndex][3] = value3;
    }
    
    rowIndex++;
  }
  return 0;
}

int setUpAlarmAndIntervals(const char* newConfiguration) {
  std::string_view config(newConfiguration);
  std::string_view::size_type current = 0;
  std::string_view::size_type end = 0;

  while (current < config.size()) {
    // Find the end of the line
    end = config.find('\n', current);
    if (end == std::string_view::npos) {
      end = config.size();
    }

    std::string_view line = config.substr(current, end - current);
    current = end + 1; // Move to the next line

    // Trim leading and trailing spaces
    while (!line.empty() && (line.front() == ' ' || line.front() == '\t')) {
      line.remove_prefix(1);
    }
    while (!line.empty() && (line.back() == ' ' || line.back() == '\t')) {
      line.remove_suffix(1);
    }

    // Parse key-value pairs
    int tempValue;
    if (line.rfind("Audiovizualne upozornenie:", 0) == 0) {
      if (sscanf(line.data(), "Audiovizualne upozornenie: %d", &tempValue) == 1) {
        settings.alarm = (tempValue != 0);
      }
    } 
    else if (line.rfind("Odpojenie systemu:", 0) == 0) {
      if (sscanf(line.data(), "Odpojenie systemu: %d", &tempValue) == 1) {
          settings.rele = (tempValue != 0); // Convert to boolean
      }
    } 
    else if (line.rfind("Interval aktualizacii:",0) == 0) {
      if (sscanf(line.data(), "Interval aktualizacii: %u", &settings.update_frequency) != 1) {
        Serial.println("Invalid update frequency format.");
      }
    } 
    else if (line.rfind("Interval logovania:",0) == 0) {
      if (sscanf(line.data(), "Interval logovania: %u", &settings.log_frequency) != 1) {
        Serial.println("Invalid log frequency format.");
      }
    } 
    else if (line.rfind("Vypnut logovanie:",0) == 0) {
      if (sscanf(line.data(), "Vypnut logovanie: %d", &tempValue) == 1) {
        settings.logging = (tempValue != 0); // Convert to boolean
      }
    }
  }

  return 0;
}
