TIS2024-FMFI/telescope-safety/src/control_unit/control_unit_A/common_structs.h

#ifndef COMMON_STRUCTS_H
#define COMMON_STRUCTS_H

#include <vector>

struct AzimuthElevation {
    double azimuth;
    double elevation;
};

struct DegreesMinutesSeconds {
    int degrees;
    int minutes;
    int seconds;
};

// Zakázaná zóna (polygón)
using ForbiddenZone = std::vector<AzimuthElevation>;

// Všetky zakázané zóny
using ForbiddenZones = std::vector<ForbiddenZone>;

enum ChangeType {
    FORBIDDEN_ZONE_CHANGED,
    LOG_FREQUENCY_AND_ALARM_TYPE_CHANGED,
    TRANSFORM_MATRIX_CHANGED,
    RESTART
};

struct Settings {
  bool rele;
  bool alarm;
  bool logging;
  unsigned int log_frequency;
  unsigned int update_frequency;
  ForbiddenZones systemForbiddenZones;
};

extern bool transMatrix;
extern bool resetflag;
extern double azimuth;
extern Settings settings;
extern int TransformMatrix[4][4];

#endif
