TIS2024-FMFI/telescope-safety/(commit log)

2024-10-26 TestRELE
    Test je cisto ilustracny pre otestovanie Rele a RPi Pico.
2024-10-31 Webserver
    Webserver for displaying actual current position
2024-10-31 Change PIN
    Zmena pinu revedena na hodine
2024-10-31 Fix. Services are now accessible from other devices.
2024-11-18 zakladny test Raspberry
2024-12-15 Sensor data monitoring
2025-01-01 Update inercial_unit_A.ino #24
    úprava kódu získavania roll, pitch, yaw na dohodnutý návrh implementácie
2025-01-07 transformation to azimuth and simulation #43
    transformation seems correct, but certainly testing on our school telescope prototype is required
    [inercial_unit_A.ino, transform_to_azimuth_elevation.cpp, transform_to_azimuth_elevation.h]
2025-01-20 reset sensor seems to be working #53
    -reseting sensor(setting off and on again after 5 seconds) seems to be working
    -also azimuth calibration send from control unit seems to be working correctly
    -also when azimuth is not required to change just reset it stays the same as before reset
    -need testing tho
    [control_unit_A.ino, gain_roll_pitch_yaw.cpp, gain_roll_pitch_yaw.h, inercial_unit_A.ino, lora_communication.cpp, lora_communication.h, reset_sensor.cpp, reset_sensor.h]
2025-01-21 It finally works
    I removed everything to make it work, just to find out the problem was number of the build in pin, that collided with ethernet pin.
    I will add everything essential later.
2025-01-21 Fix to work with bools
    [httpHandlers.cpp]
2025-01-22 WS handshake works
    Still need to add correct frame sending.
    I Am just happy the hand shake works
    [servers.cpp, servers.h]
2025-01-23 Unified
    Olaaaa 🐹 🐤 🦊 🦝
2025-01-24 Add test print for time
2025-01-25 handling acknowledge message through flag
    handilng acknowledge message from inertial unit after sending reset command through flag in loop, no in function to send reset as previously
    [control_unit_A.ino, lora_communication.cpp]
2025-01-27 diffrent error code returned when bad format #26
    [forbidden_zones_config_parse.cpp]
2025-01-27 feat: add web-socket handlers
2025-01-28 Settings redesign and RELE turn OFF
    [common_structs.h, control_unit_A.ino, danger_evaluation.cpp, danger_evaluation.h, httpHandlers.cpp, logs.cpp]
2025-01-28 Added loading from SD card
    Needs some work on loading current configuration into the form
2025-01-31 odstranenie cyklu z volania resetovania inercialnej jednotky
    [control_unit_A.ino]
2025-02-04 Dont get stuck in setup loop when not internet (DHCP) available)
    Needs to be properly tested on HW and network tomorrow
    [control_unit_A.ino, servers.cpp]
2025-02-05 Adding warnings and errors for client
    [servers.cpp, servers.h]
2025-02-07 okomentovanie buttonov
2025-02-08 Adding test prints
2025-02-08 another icm sensor works with the code automatically if switched
2025-02-09 third sensor ism works automatically when manually put on, high accuracy
2025-02-09 reset-azimuth calibration best version
    [gain_roll_pitch_yaw.cpp, gain_roll_pitch_yaw.h, lora_communication.cpp, reset_sensor.cpp, reset_sensor.h, transform_to_azimuth_elevation.cpp, transform_to_azimuth_elevation.h]
2025-02-10 thirds sensor commit
2025-02-10 reset lora every 5 minutes, quaternion repair
    [gain_roll_pitch_yaw.cpp, lora_communication.cpp]
2025-02-11 reser final repair for third sensor when calibrating azimuth
2025-02-11 adding ism sensor library
2025-02-13 after reset sensor detection is independant from compilation
    [gain_roll_pitch_yaw.cpp]
